AndresNavarro82/vt52-fpga/img/emacs.jpg

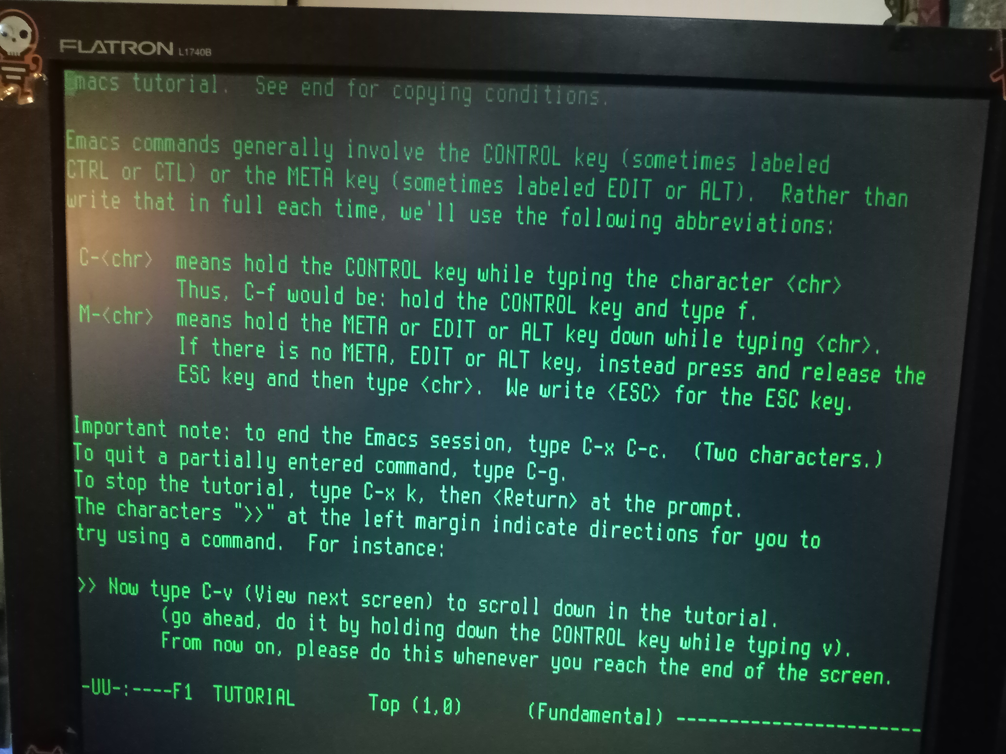
img/emacs.jpg
