AndresNavarro82/vt52-fpga/img/keyboard.jpg

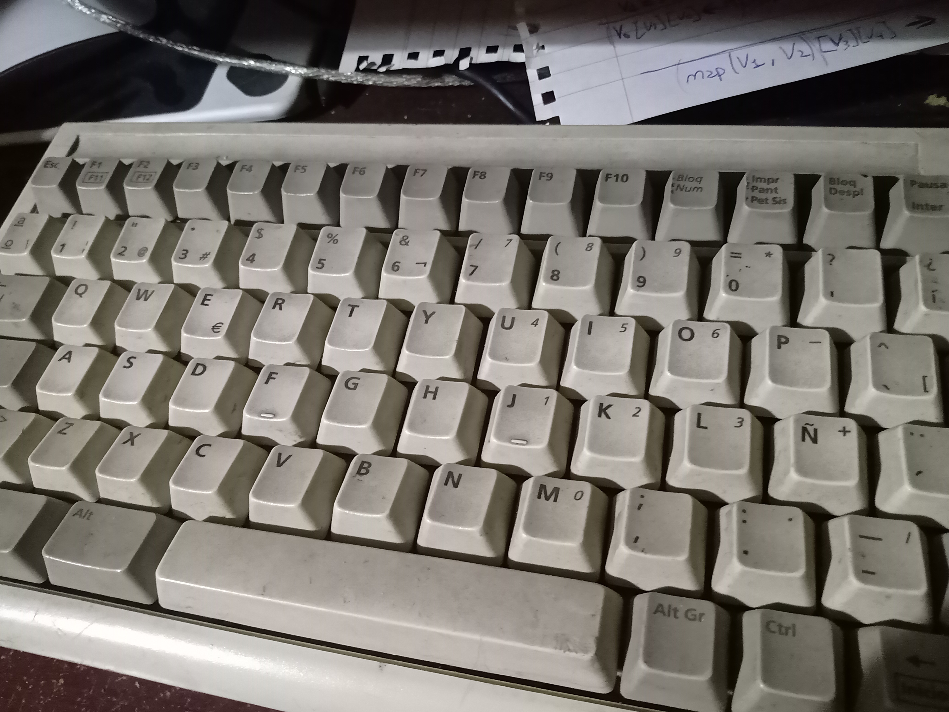
img/keyboard.jpg
