AndresNavarro82/vt52-fpga/img/tinyfpga.jpg

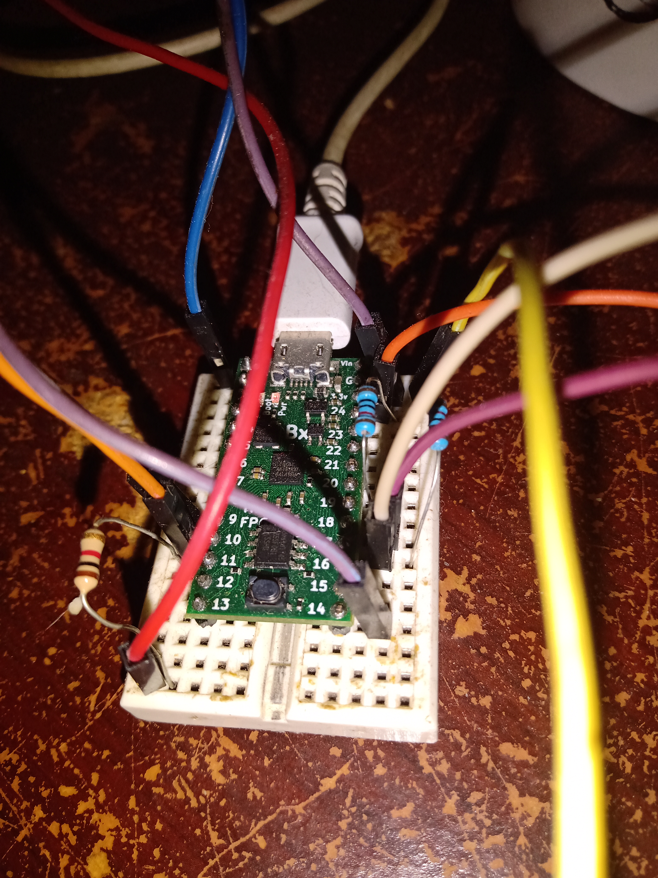
img/tinyfpga.jpg
