AndresNavarro82/vt52-fpga/img/vga.jpg

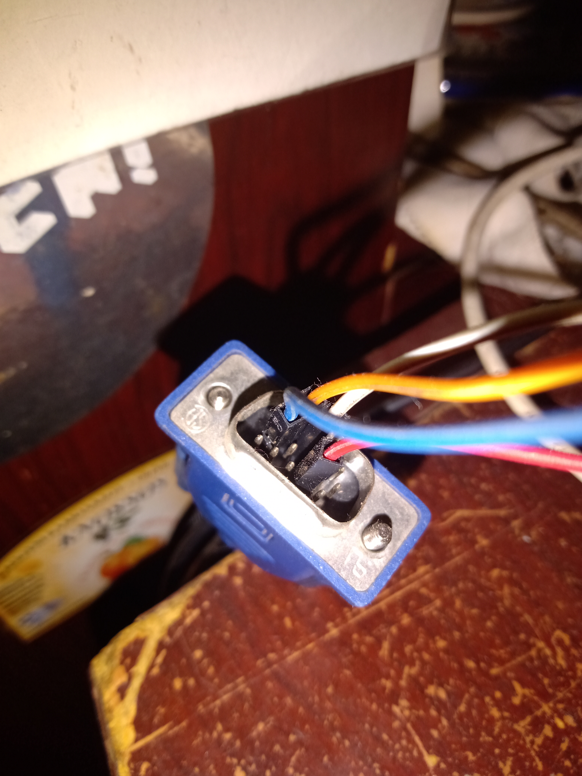
img/vga.jpg
