AndresNavarro82/vt52-fpga/img/vim.jpg

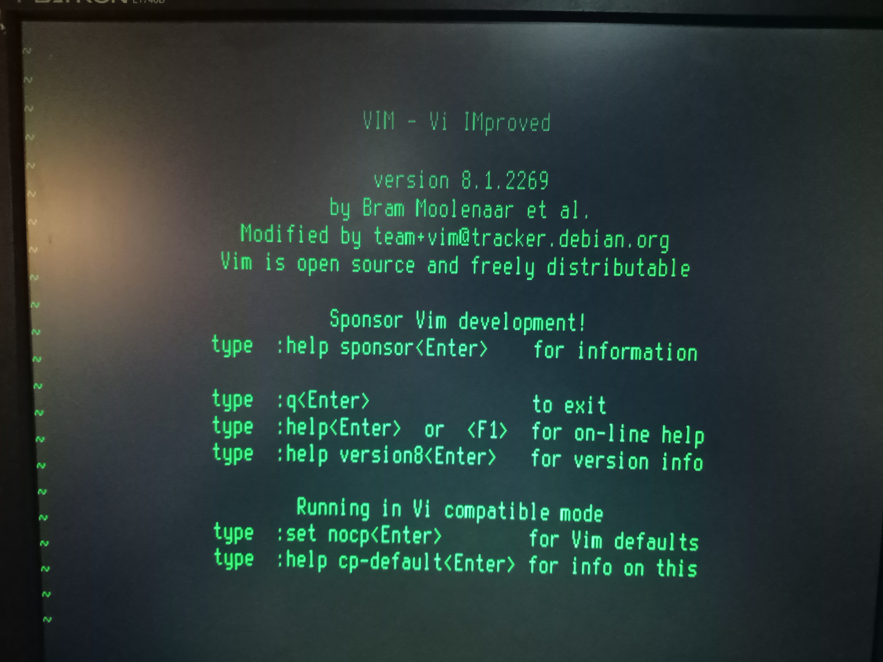
img/vim.jpg
