AndresNavarro82/vt52-fpga/(threads)

Thread 1 (2020-11-05):

very cool!

jhcloos, 2020-11-05:
i saw your note to the tinyfpga list and started reading the code…

it might be interesting to implement the bell as a flashing led.

i do not recall wheter the vt52's bell supports varied frequency and/or
duration, the led coulf light for however long a vt52 would have emitted
audio.

or if not an onboard led, then perhaps voltage to an io pin...

AndresNavarro82, 2020-11-05:
Well, I haven't seen one in the flesh, but from what I've gathered the "bell" was actually produced by some kind of relay and the sound was quite unique.  I think it also used a similar technique to simulate a "typewriter" sound when each key was pressed.

Here the bell could be implemented either via a short pulse or an oscillating value for a few ms.  You could put either a led or one of those buzzers that are popular with Arduinos.  The onboard led is currently assigned to follow the cursor blinking (only to have some indication of activity on the board) but could easily be reassigned in the pcf file.

As for the implementation, it should just be a matter of adding a case entry in command_handler.v, adding an output there and adding a buzzer module with the appropriate counter to turn off after a while (and oscillate if desired)

voronoipotato, 2020-11-06:
I wonder how much more effort it would be to make this work over SSH. I've often thought it would be really cool to have a low power SSH only terminal. Normally I would have thought it kinda impossible but you've already done the whole terminal part :P. I was thinking maybe you could have a host that just SSH'es and communicates to the FPGA over serial.

Thread 3 (2021-06-09):

USB interface wiring

DavidJRichards, 2021-06-09:
Greetings Andres, I am having a go at running your terminal. Limited results so far as I have only a flashing led and cursor on the VGA output but no sensible results when I connect the USB. I can't tell if the keyboard is working yet.

Please could you describe the USB interface, I see some resistors in the photo? how are these connected and what values are you using?

The platform I'm using is ebaz4205 zynq 7010.
Kind regards, David.

AndresNavarro82, 2021-06-10:
Hi David.  If you are talking about the keyboard connection, it's an old style ps/2 connector, not a usb keyboard.  I'm only using usb for the serial port to the pc.

With that in mind, the keyboard ps/2 connection has 4 wires: gnd, vcc, clk and data.

Vcc is supposed to be 5V, but I was able to use the 3.3v from the fpga without problems on the keyboards I tried so far.
clk and data are both open collector outputs (at least according to the standard),  If you connect the keyboard VCC to 5V I would measure/scope clk and data before connecting them to an fpga pin, just in case, because some out of spec keyboards have an internall pullup to VCC, and in that case you can damage the pin/fpga.  If you connect vcc to 3.3v then you are safe.

In order to connect the clk and data open-collector signals you have to add at least a pullup from 3.3v to each one.  While you could try with internal pullups on the fpga (check the specs), if you are not sure, it's safer to use external resistors.  I used whatever I had at hand (I think they were like 4k7ohms or so).  See the following post for the general idea (and notice that the cap and series resistor are optional, but desirable): https://electronics.stackexchange.com/a/92100

I hope you manage to get it working.  Let me know if you can help you further.
Regards,
Andres Navarro

DavidJRichards, 2021-06-10:
Hi Andres, thanks for the reply.
My problem was not knowing the value of the resistors on the USB serial port. I tried and guessed some values and managed to make it work. I used 47R plus an existing 10R in series with the D+ and D- data signals. I found a 2k2 or internal pull up was ok for the D+ identification signal.

The PS/2 keyboard I have already been using - I find internal or external pull-ups work. my system has 10K external pull up.

Everything seems to be working as expected. For the ebaz4205 I needed to change the pll to suit the zynq. My system has a 33.333MHz clock which is being used for the main logic with a pll to generate the 48MHz usb clock.

In the future intend to adapt this design to incorporate it into a LVDS panel drive I have working but that shall start later. For now I shall tidy the code changes and publish the results in a fork of your repo.
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

Kind regards, David.

AndresNavarro82, 2021-06-10:
Sorry I misunderstood your question, but I am glad to see you figured it out.  I didn't have to deal with that, because the board I am using has the usb onboard: https://github.com/tinyfpga/TinyFPGA-BX/blob/master/board/TinyFPGA-BX-Schematic.pdf

It uses similar values to what you found: 68 ohms in series with d+ and d-, and a 1.5k pullup on d+

Closed 2021-06-10.

Thread 4 (2021-06-15):

keyboard cursor keys

DavidJRichards, 2021-06-15:
I have found in my version that the keyboard cursor controls give lower case ESC letter sequences a,b,c,d. According to the documents I have read these should be upper case, I have edited the keyboard file to suit and now I am able to use the keys. Using vt52-fpga as a linux terminal nano now works properly as a screen editor.
```
// up arrow (Esc-A)
@475
c1
@575
c1
@675
c1
@775
c1
// down arrow (Esc-B)
@472
c2
@572
c2
@672
c2
@772
c2
// right arrow (Esc-C)
@474
c3
@574
c3
@674
c3
@774
c3
// left arrow (Esc-D)
@46b
c4
@56b
c4
@66b
c4
@76b
c4
```

AndresNavarro82, 2021-06-15:
Yeah, an oversight on my part.  I guess it shows that I don't use the arrow keys much...
Thanks, I'll fix it at once

AndresNavarro82, 2021-06-15:
Should be fixed, didn't test it but seems like a pretty straightforward fix

Closed 2021-06-15.

Thread 5 (2021-06-15):

Add reset SE0 detection

DavidJRichards, 2021-06-15:
A verilog file exists in the package to monitor the usb lines for a SE0 reset condition though it is not enabled in the design. The downside of this is that the device does not respond to a SE0 reset condition and it is not possible to recover from a disconnection without re-starting the fpga task.

Adding the missing IP to fix these two issues is a simple matter of adding the usb_reset_det and combining its output with clk_reset signal, this is how it is implemented in usb_uart my zynq version:

```
    usb_reset_det usb_reset_det (
    .clk(clk_48mhz),
    .reset(det_reset),
    .usb_p_rx(usb_p_rx),
    .usb_n_rx(usb_n_rx)
    );

    usb_uart_core u_u_c_np (
        .clk_48mhz  (clk_48mhz),
        .reset      (reset || det_reset),

```
With the change applied the device re-connects when the USB is re-connected, also a USB reset and enumeration may be triggered by shorting D+ to gnd momentarily, this can be done under program control if required using the pin_pu output.

AndresNavarro82, 2021-06-15:
Looks good.  I didn't look much into it when I added the usb_uart, just a quick port when I moved from the Icestick (that has a regular FTDI usb-serial chip) to the TinyFpgaBX.

Let me test it and I'll update the repo (with credit to you of course, or you can do a PR if you prefer)

DavidJRichards, 2021-06-15:
Here is a little program to help test the usb reset if you need it.
https://github.com/DavidJRichards/vt52-fpga/blob/main/usbreset/readme.md
