AndresNavarro82/vt52-fpga/(commit log)

2020-10-02 Initial commit: working vga, 80x25 random text (1280x1024@60Hz)
2020-10-02 Factored out the pll & led_counter modules to new files
2020-10-02 Bugfix: off by one when calculating the next char to be drawn
    [vga.v]
2020-10-02 Bugfix: fixed some timing issues that were causing artifacts
    [vga.v]
2020-10-02 Bugfix: some more timing issues causing glitches
    [vga.v]
2020-10-02 Added blinking cursor (still seeing some glitches...)
    [vga.v]
2020-10-07 Added the remaining punctuation & symbol keys. Fixed typos
    [vga.v]
2020-10-09 Ported this to the TinyFPGA Bx: pins, leds, clock/pll & makefile
2020-10-09 Refactor: Corrected some Diamond warnings & changed some tabs to spaces
    [char_generator.v, vga.v]
2020-10-10 Changed the resolution to 640x400, at just below 70Hz
2020-10-10 Bugfix: swapped '.' & ','
    [vga.v]
2020-10-10 Added support for the first Escape code: Esc H sends the cursor home
2020-10-10 Bugfix: forgot to change back to idle state after Esc H
2020-10-10 Added the remaining basic cursor ESC codes
2020-10-10 Bugfix: now using usb reset because it wasn't intializing properly
    [vga.v]
2020-10-10 Added the absolute cursor positioning esc code
2020-10-10 Added line and screen erasing esc codes
2020-10-10 Bugfix: when scrolling the register was loading the wrong value
    [char_generator.v]
2020-10-18 80x24 and unified all clocks @48MHz, image slightly unstable
    [char_generator.v, vga.v]
2020-10-18 Refactor: pipelined the Esc-Y command
2020-10-18 Bugfix: Esc-Y, there was an overflow and an off by one error
2020-10-21 Combined the sync & char generator, solved some clock delays there
    [char_generator.v, vga.v]
2020-10-22 Buffered syncs and blanks, fixed some delays
    [char_generator.v]
2020-10-22 Changed all async clears to synchronous resets. Some cleaning
    [char_generator.v, cursor_position.v, vga.v]
